GuanyuXu04/Maglev/scripts/coil_fit.png

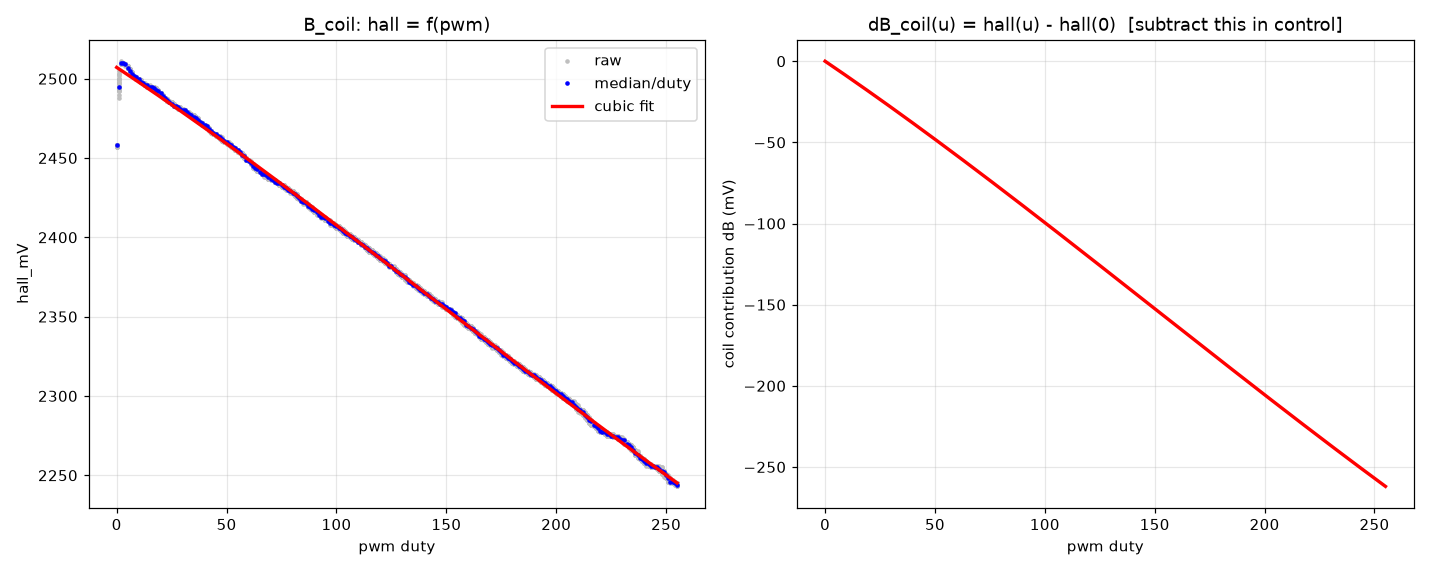
scripts/coil_fit.png
