GuanyuXu04/Maglev/scripts/PM2_fit.png

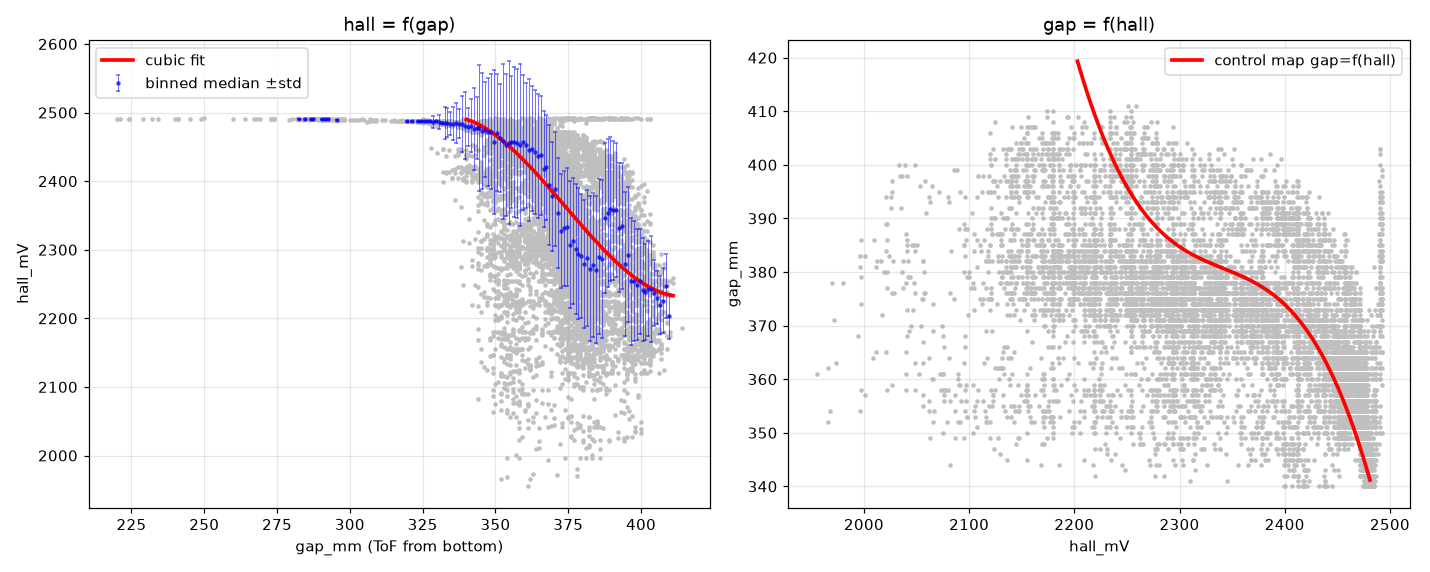
scripts/PM2_fit.png
