GuanyuXu04/Maglev/scripts/PM3_fit.png

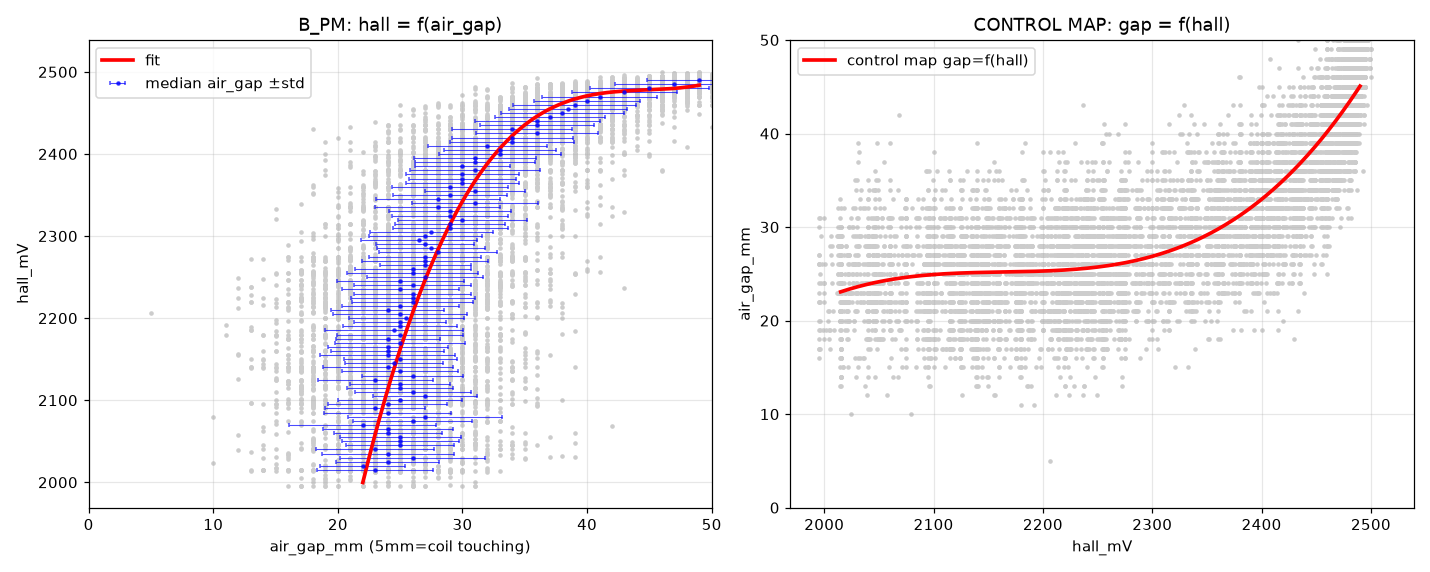
scripts/PM3_fit.png
