GuanyuXu04/Maglev/scripts/PM_plot.png

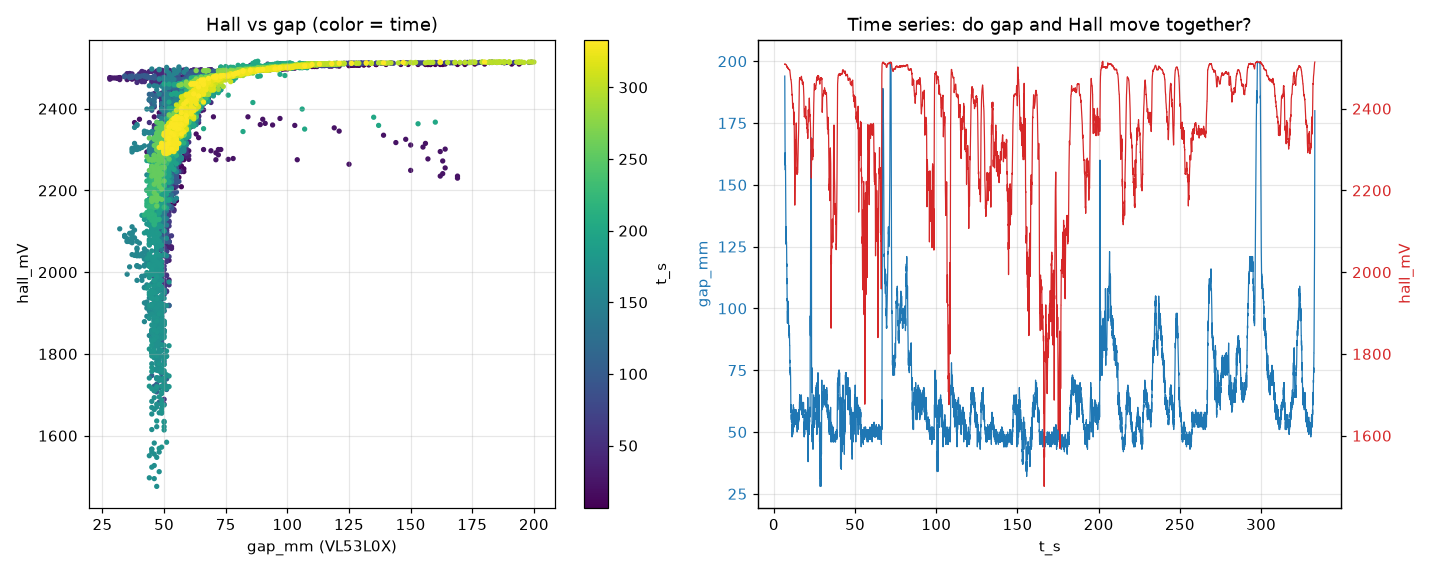
scripts/PM_plot.png
