GuanyuXu04/Maglev/scripts/process_data/figures/steady_state_error.png

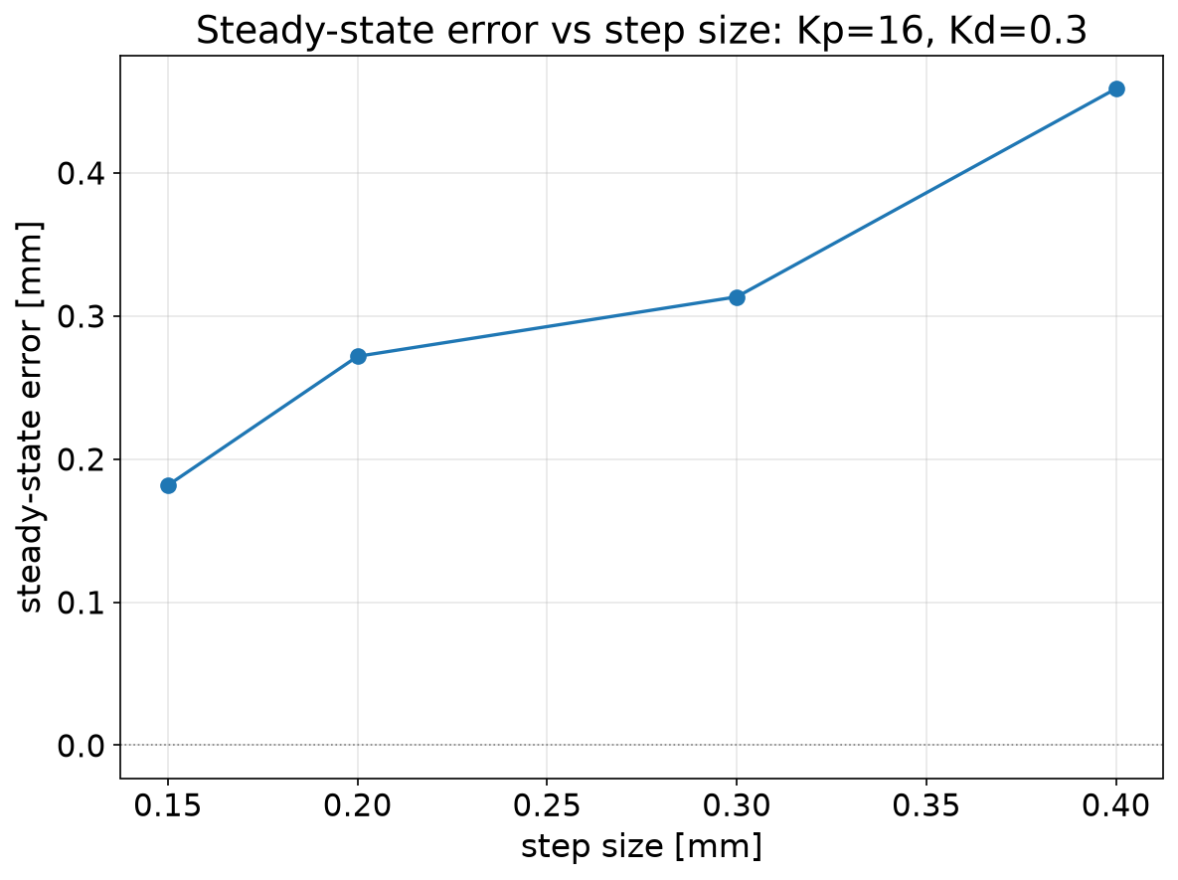
scripts/process_data/figures/steady_state_error.png
