GuanyuXu04/Maglev/scripts/sweep_kp_kd/steady_state_error_heatmap.png

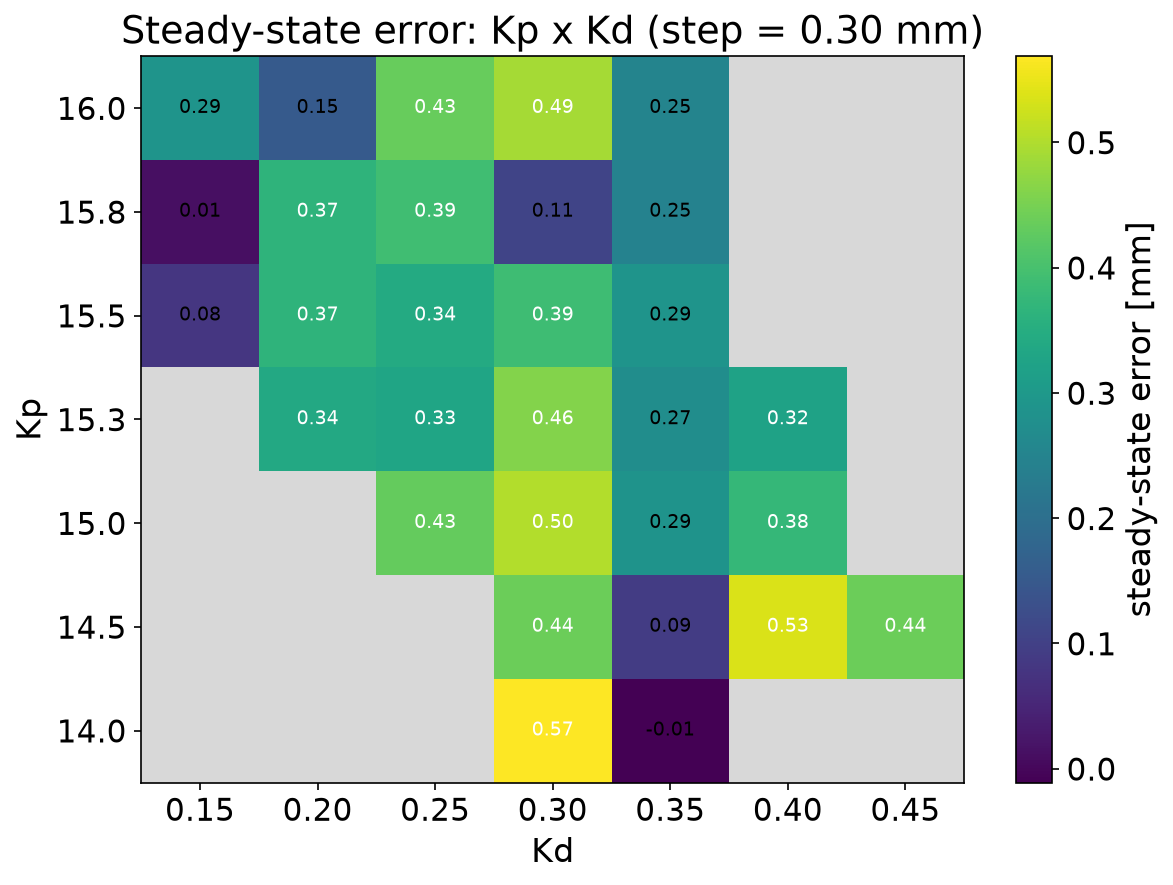
scripts/sweep_kp_kd/steady_state_error_heatmap.png
