GuanyuXu04/Maglev/scripts/process_data/figures/data_step_0.30.png

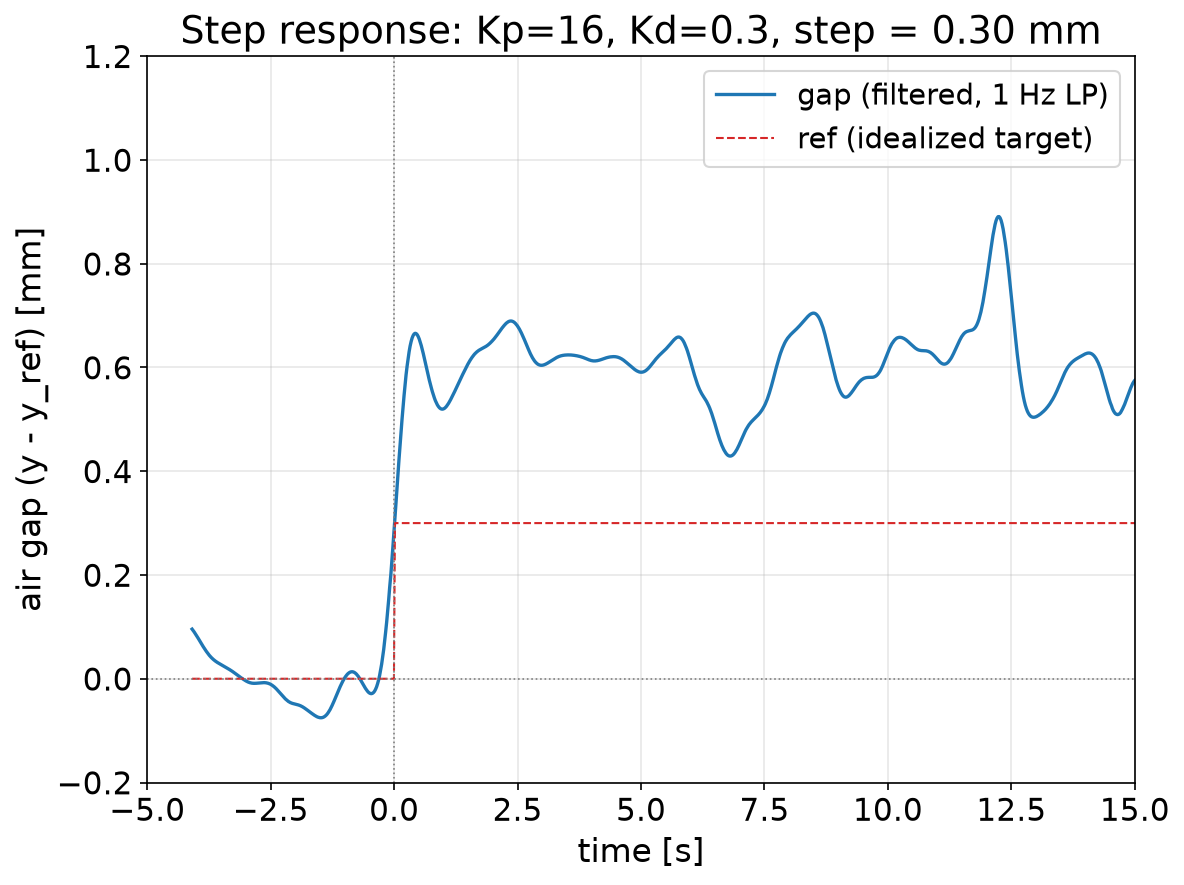
scripts/process_data/figures/data_step_0.30.png
