GuanyuXu04/Maglev/scripts/process_data/figures/data_step_0.60.png

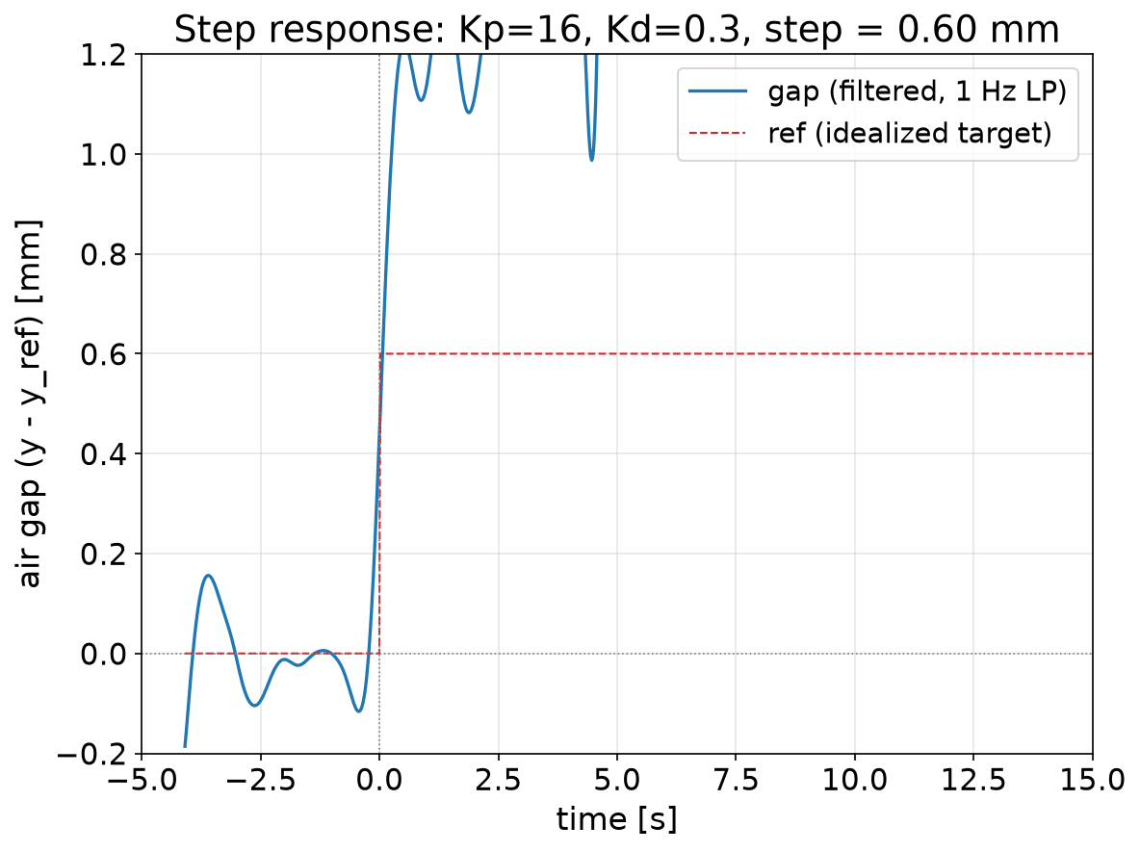
scripts/process_data/figures/data_step_0.60.png
