GuanyuXu04/Maglev/scripts/process_data/figures/step_comparison.png

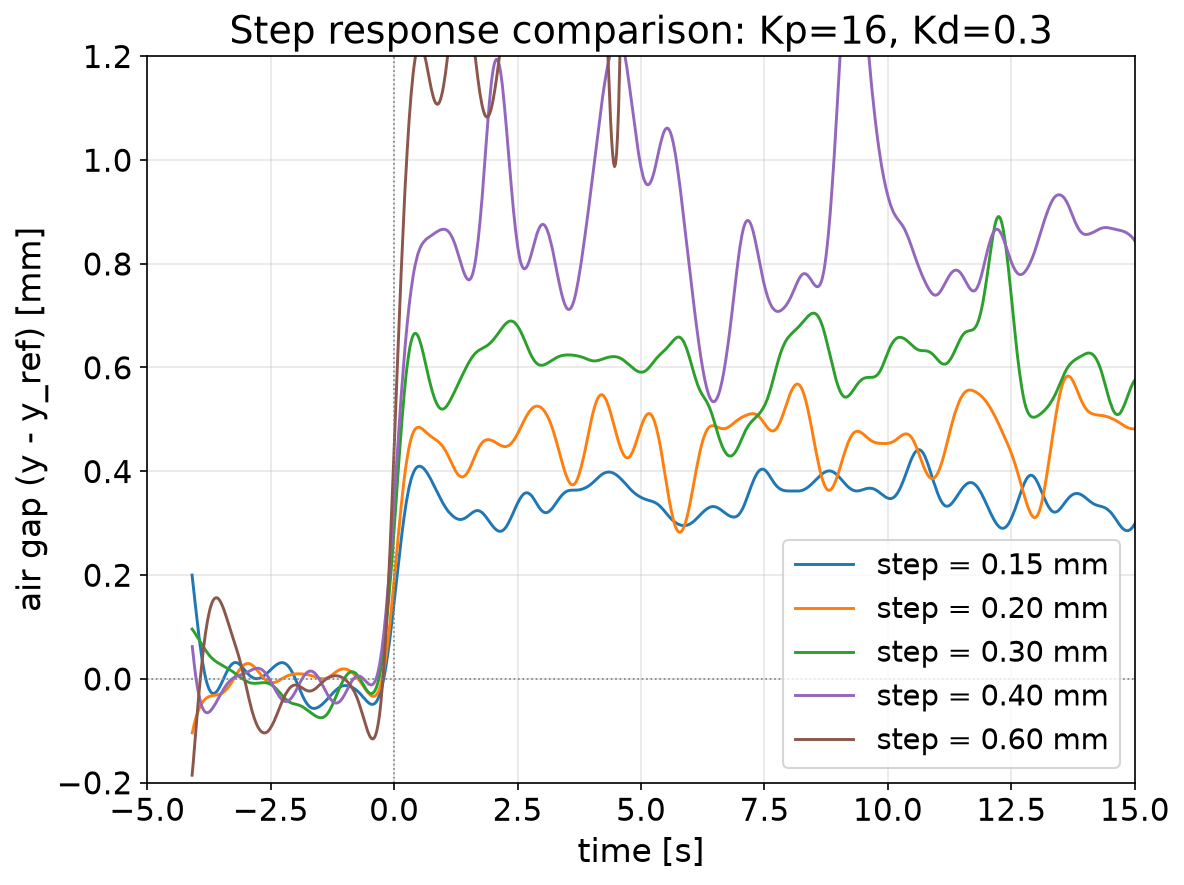
scripts/process_data/figures/step_comparison.png
