GuanyuXu04/Maglev/scripts/sweep_kp_kd/step_kp14.0_kd0.35.png

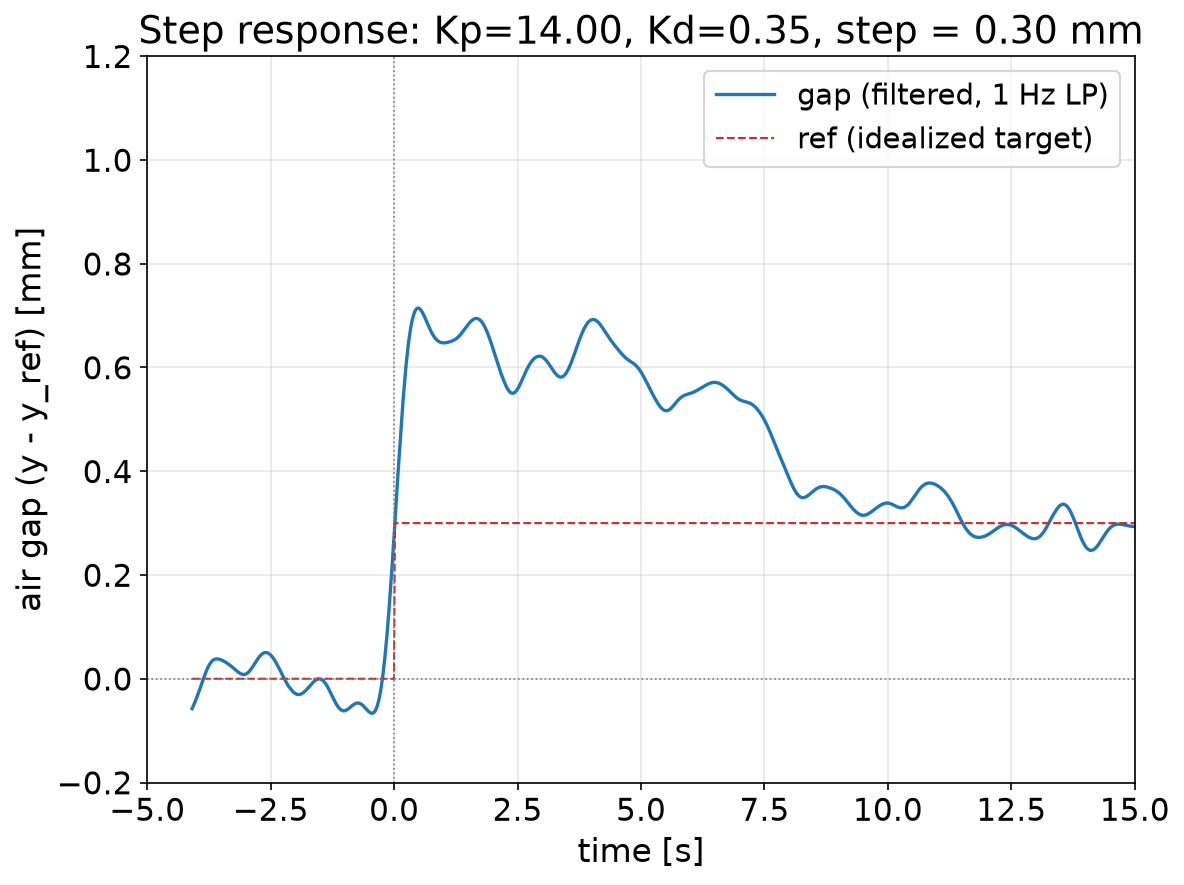
scripts/sweep_kp_kd/step_kp14.0_kd0.35.png
