GuanyuXu04/Maglev/scripts/sweep_kp_kd/step_kp14.5_kd0.30.png

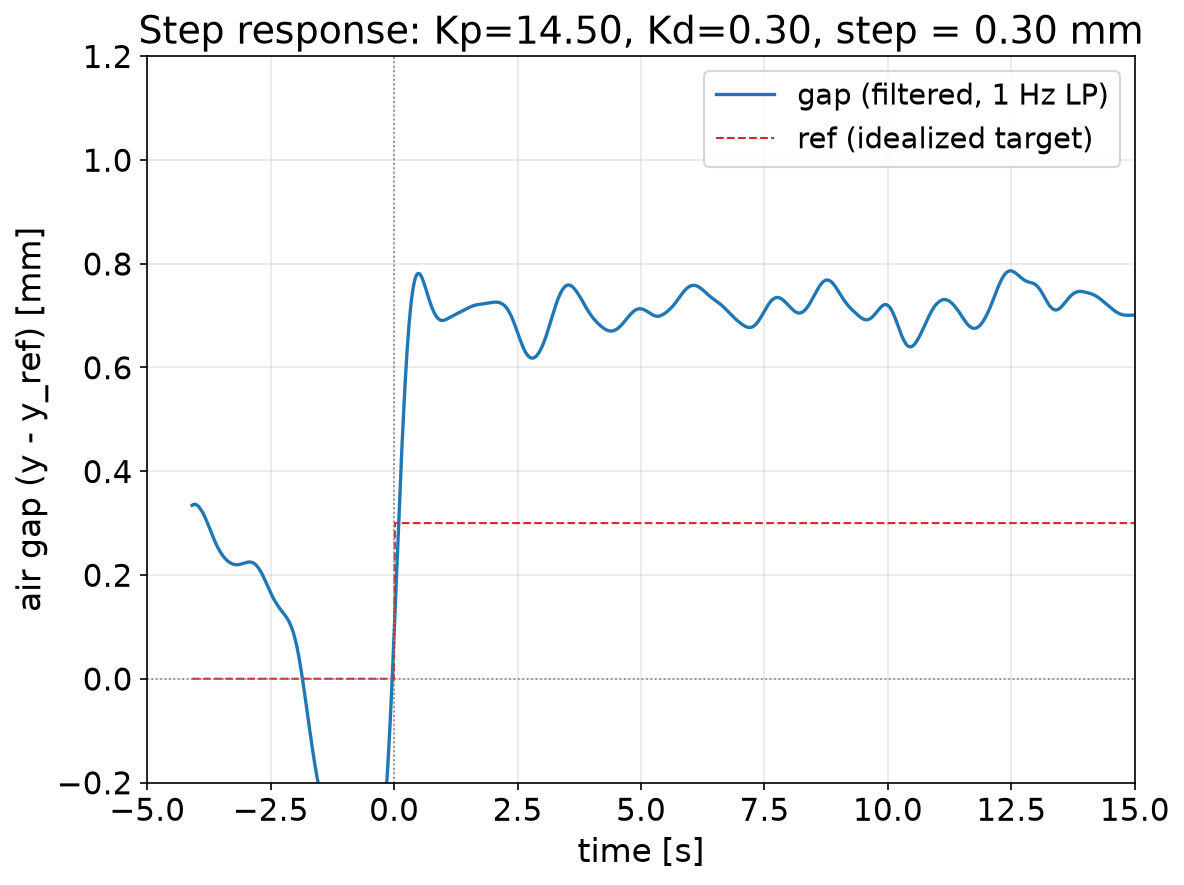
scripts/sweep_kp_kd/step_kp14.5_kd0.30.png
