GuanyuXu04/Maglev/scripts/sweep_kp_kd/step_kp15.0_kd0.20.png

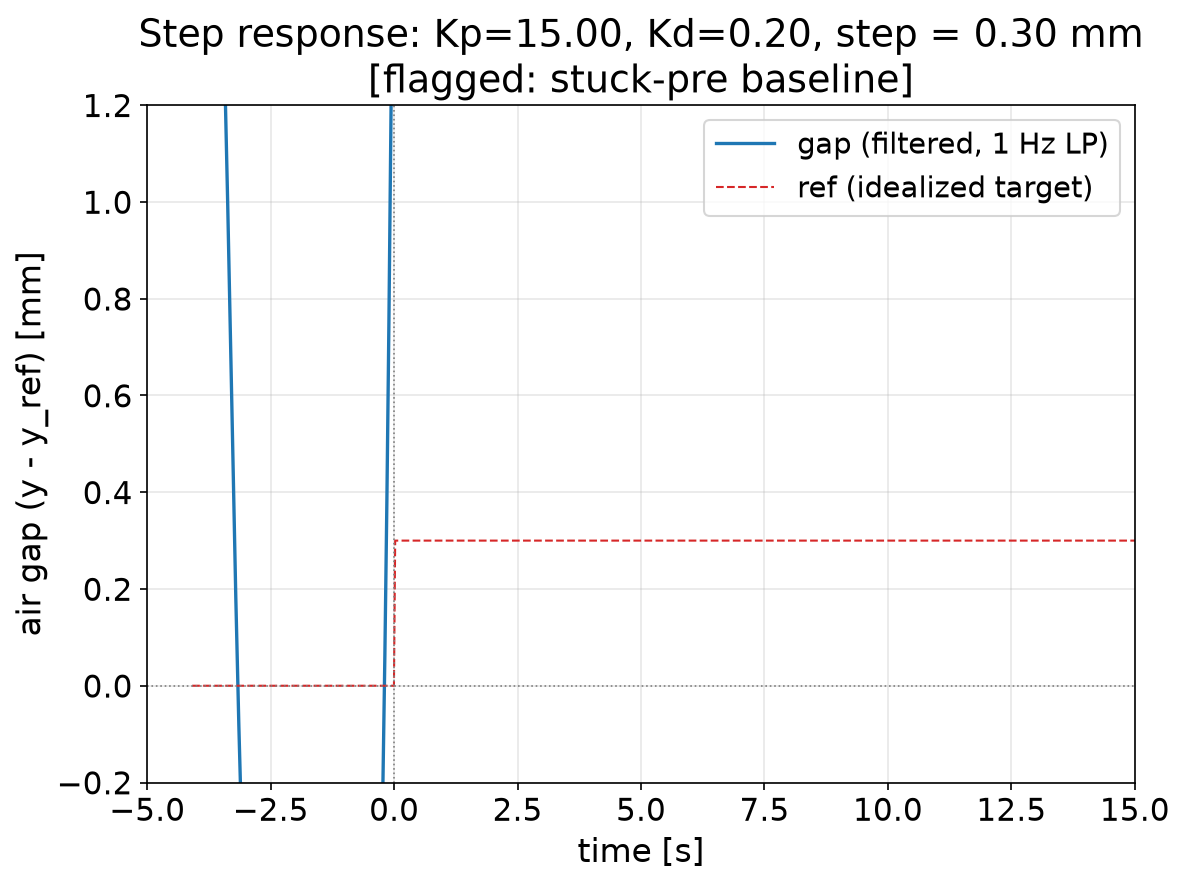
scripts/sweep_kp_kd/step_kp15.0_kd0.20.png
