GuanyuXu04/Maglev/scripts/sweep_kp_kd/step_kp15.0_kd0.25.png

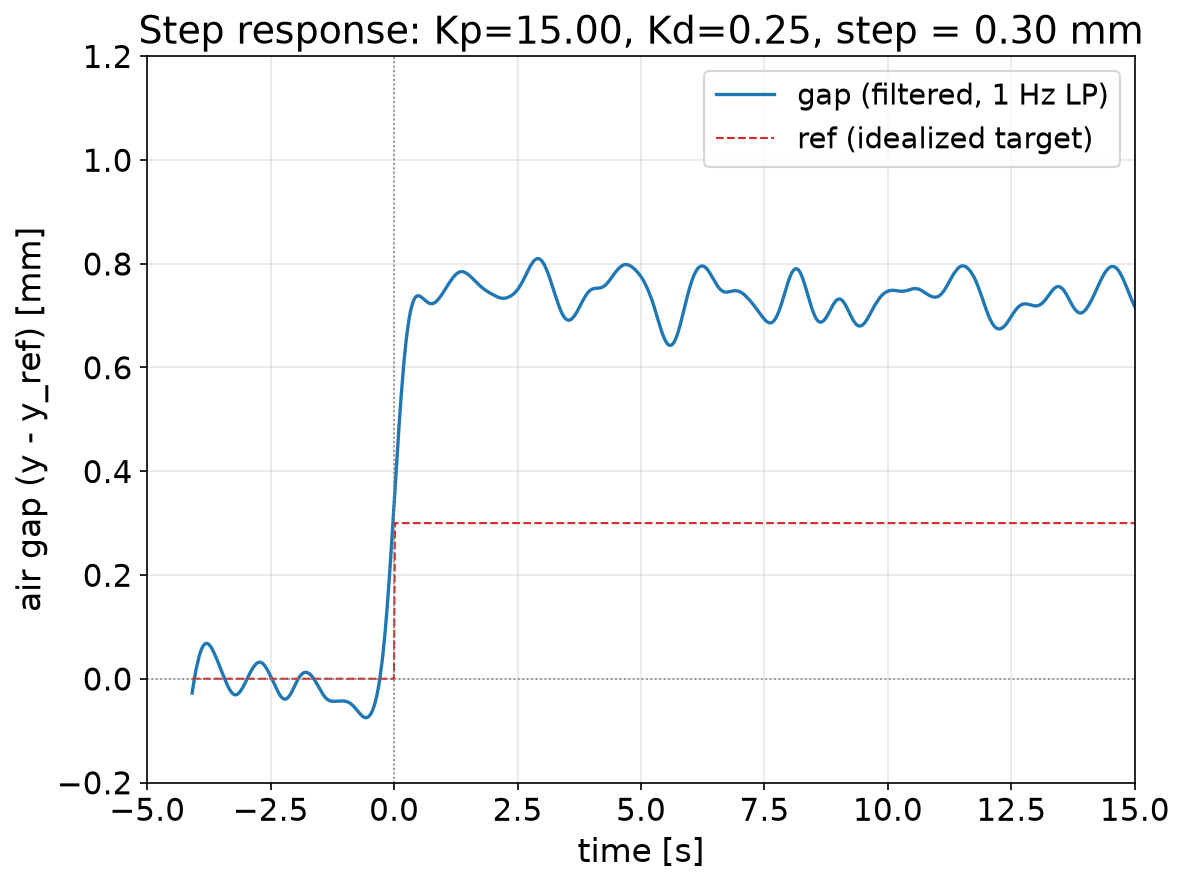
scripts/sweep_kp_kd/step_kp15.0_kd0.25.png
