GuanyuXu04/Maglev/scripts/sweep_kp_kd/step_kp15.0_kd0.30.png

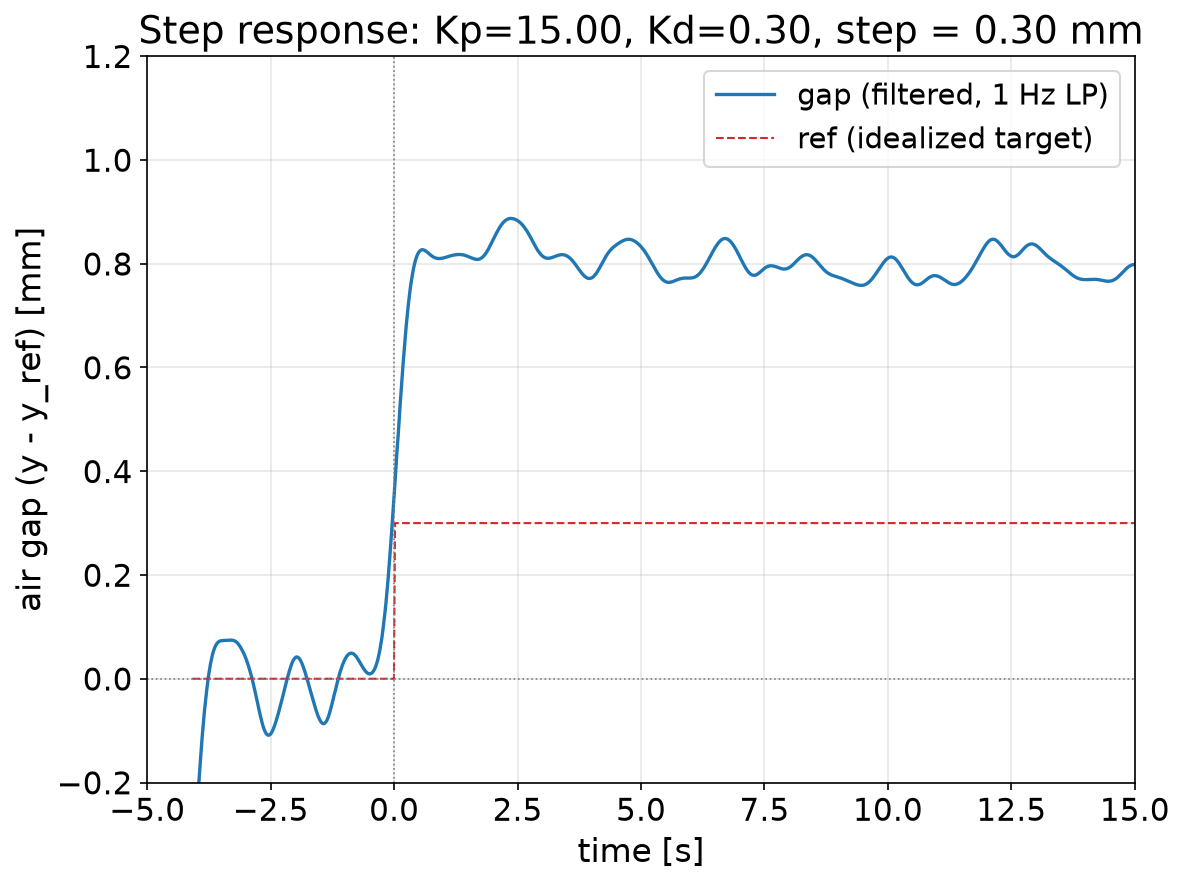
scripts/sweep_kp_kd/step_kp15.0_kd0.30.png
