GuanyuXu04/Maglev/scripts/sweep_kp_kd/step_kp15.3_kd0.25.png

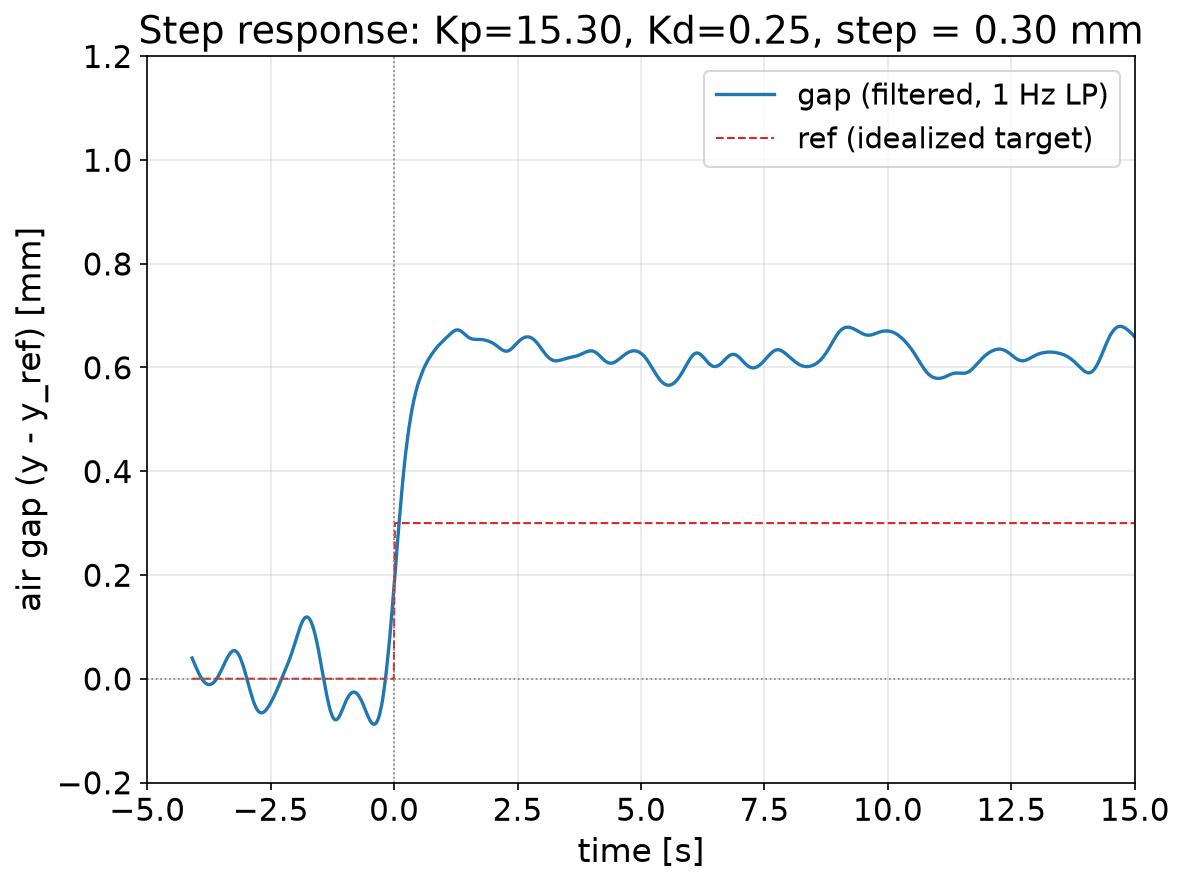
scripts/sweep_kp_kd/step_kp15.3_kd0.25.png
