GuanyuXu04/Maglev/scripts/sweep_kp_kd/step_kp15.5_kd0.35.png

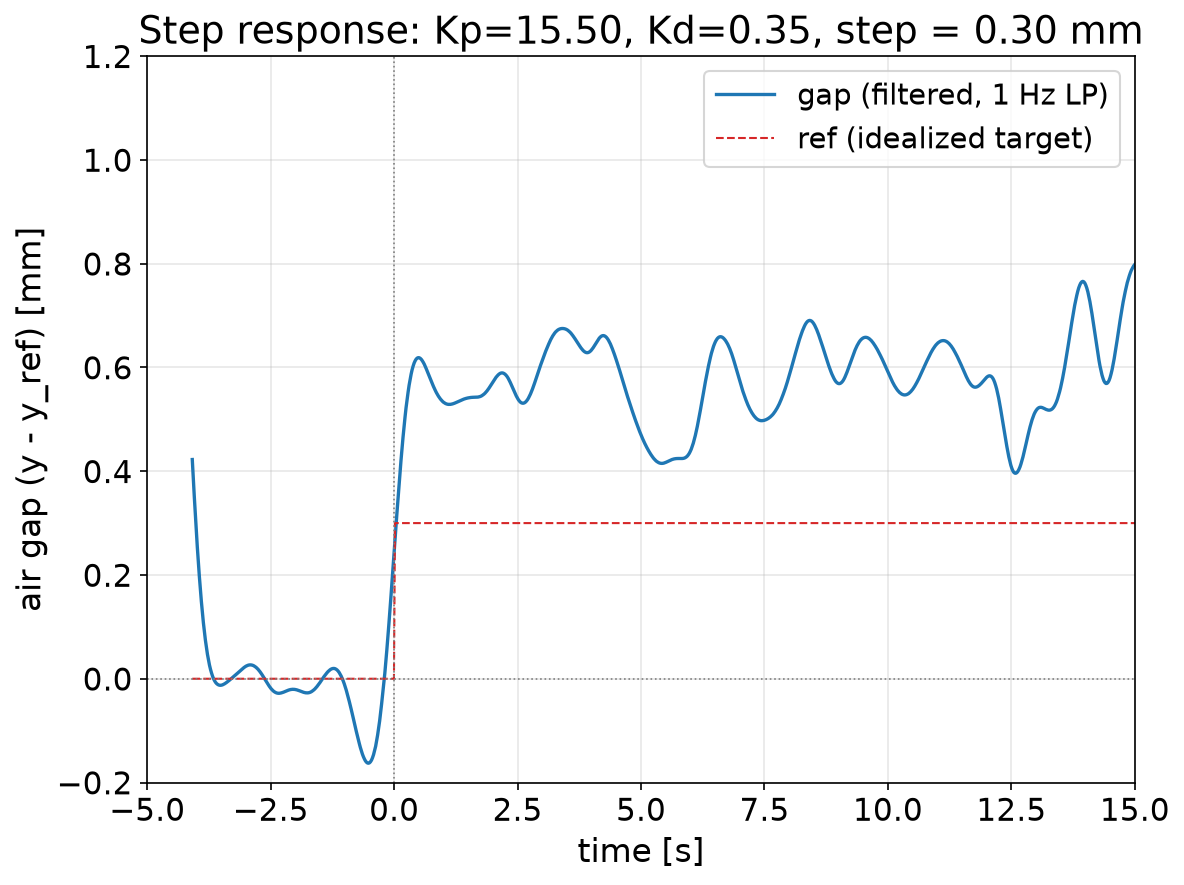
scripts/sweep_kp_kd/step_kp15.5_kd0.35.png
