GuanyuXu04/Maglev/scripts/sweep_kp_kd/step_kp15.5_kd0.40.png

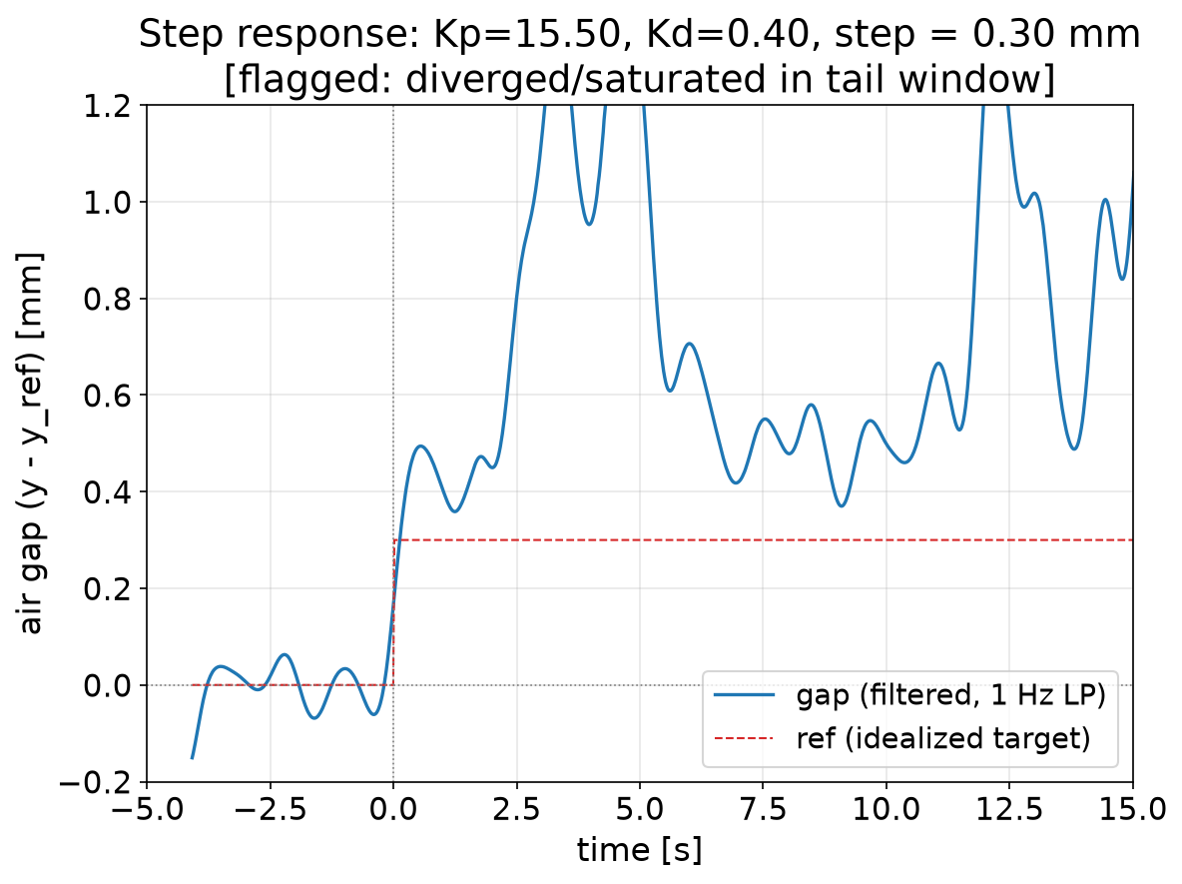
scripts/sweep_kp_kd/step_kp15.5_kd0.40.png
