GuanyuXu04/Maglev/scripts/sweep_kp_kd/step_kp15.8_kd0.15.png

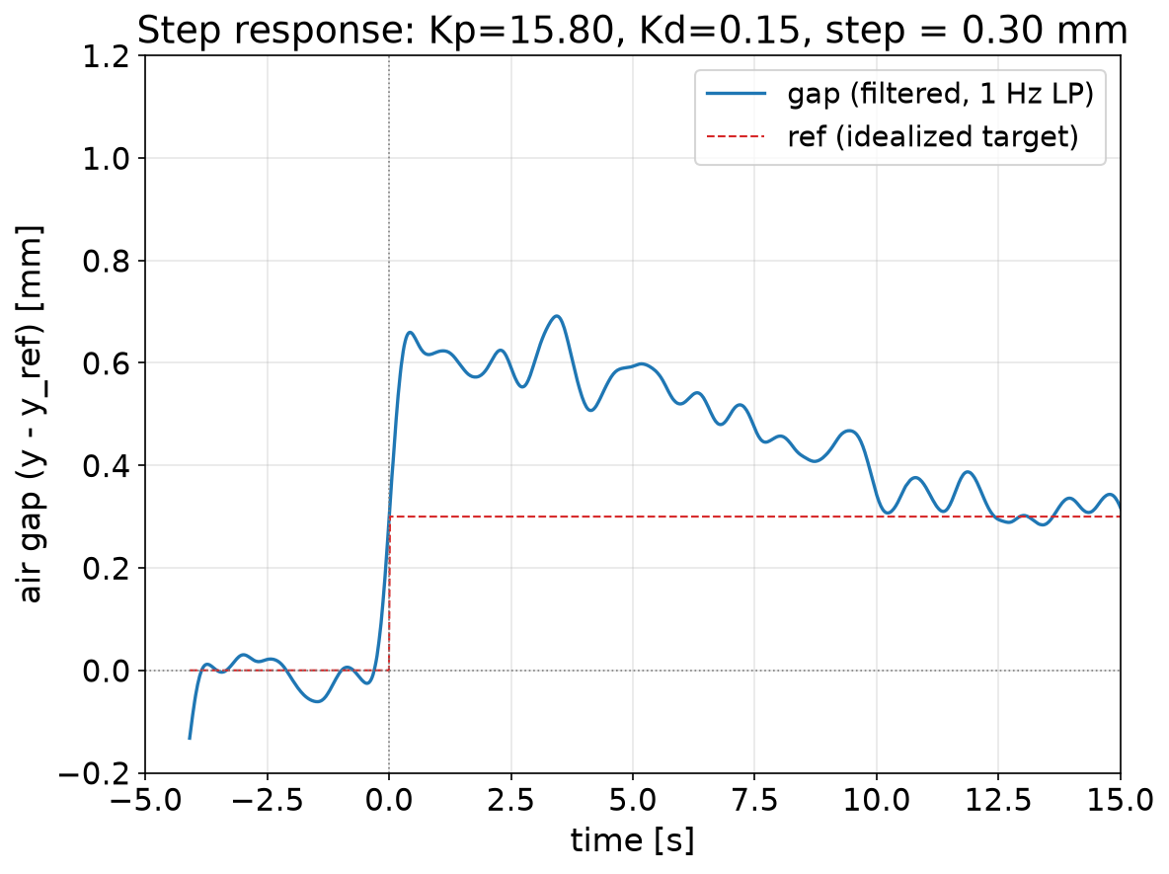
scripts/sweep_kp_kd/step_kp15.8_kd0.15.png
