GuanyuXu04/Maglev/scripts/sweep_kp_kd/step_kp15.8_kd0.35.png

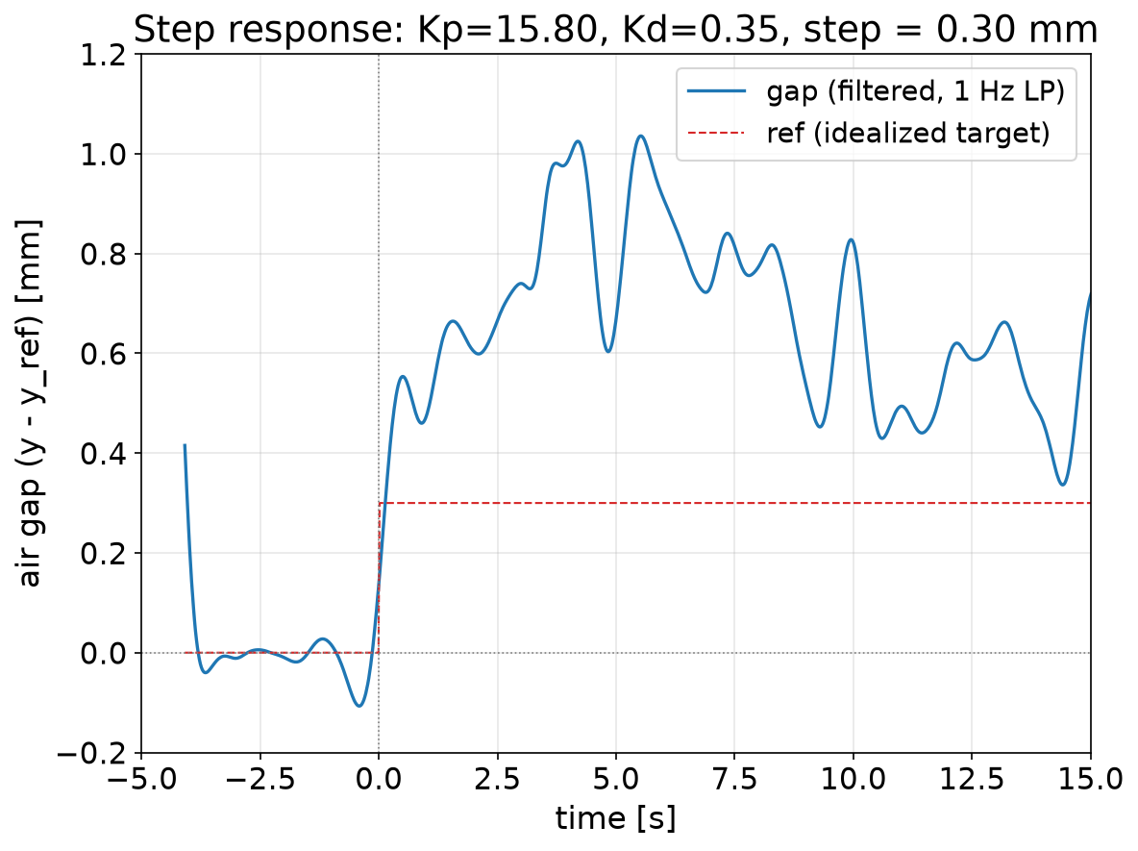
scripts/sweep_kp_kd/step_kp15.8_kd0.35.png
