GuanyuXu04/Maglev/scripts/sweep_kp_kd/step_kp16.0_kd0.15.png

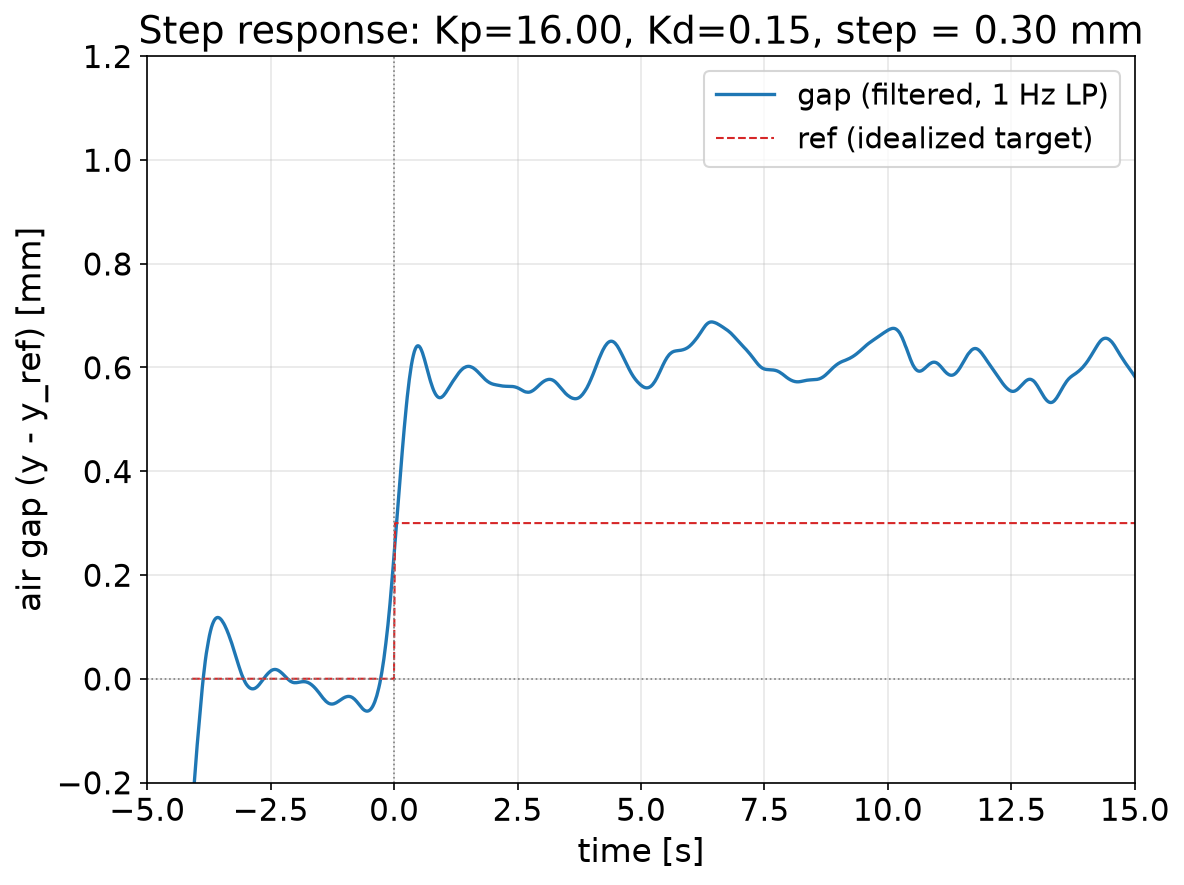
scripts/sweep_kp_kd/step_kp16.0_kd0.15.png
