GuanyuXu04/Maglev/scripts/sweep_kp_kd/step_kp16.0_kd0.35.png

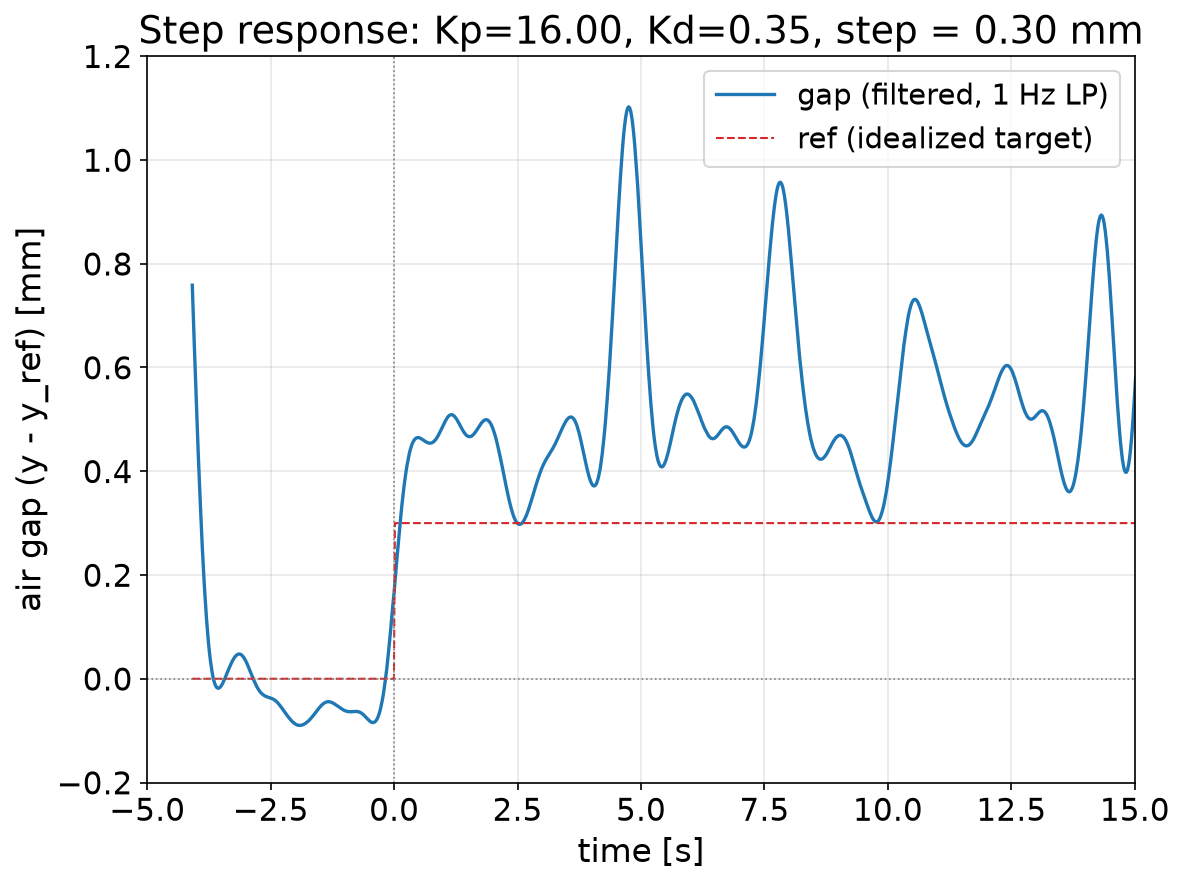
scripts/sweep_kp_kd/step_kp16.0_kd0.35.png
