GuanyuXu04/Maglev/scripts/sweep_step_kp16_kd0.3/data_step_0.40_normalized.png

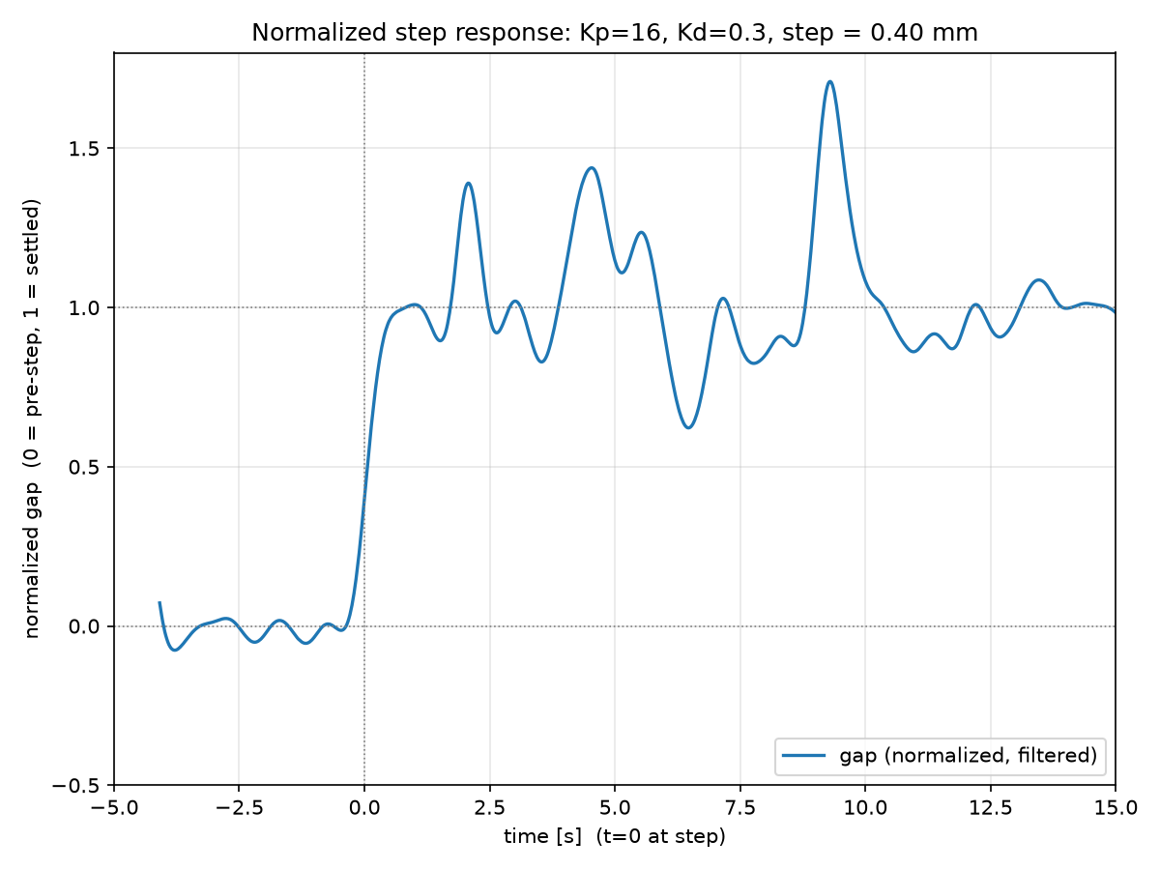
scripts/sweep_step_kp16_kd0.3/data_step_0.40_normalized.png
