GuanyuXu04/Maglev/python/maglev_sim/params.py

"""Single source of truth for every physical/design parameter.

See ../../PARAMETERS.md for the full discussion of where each number comes
from (direct measurement, design choice, or derived via calibration). Every
number here is a *placeholder* self-consistent with the equilibrium
equation `m*g = K*i0/y0**2 + K_pm/y0**4` (the second term is the
permanent-magnet-on-core attraction added to the plant model -- see
PARAMETERS.md "Permanent-magnet core-magnetization force") -- not a claim
about any real hardware.

The Arduino sketch (arduino/maglev_controller/maglev_controller.ino) hardcodes
the same numeric values in its constants block. `tests/test_maglev_sim.py`
parses that file and checks it against this module so the two cannot
silently drift apart -- if you change a value here, update the .ino too.
"""

from dataclasses import dataclass


@dataclass(frozen=True)
class PlantParams:
    """Physical constants. Bucket A (measure) + Bucket C (derive from calibration)."""

    g: float = 9.81          # m/s^2 -- standard gravity, not measured
    m: float = 0.020         # kg -- PLACEHOLDER, replace with a scale reading
    R: float = 8.0           # ohm -- PLACEHOLDER, replace with a multimeter reading
    L: float = 0.020         # H   -- PLACEHOLDER, replace with an LR step-response test
    K: float = 1.1649375e-3  # N*m^2/A -- coil constant, derived via K_from_equilibrium()
                             # so the coil AND K_pm together satisfy equilibrium (below)
    K_pm: float = 6.13125e-8 # N*m^4 -- permanent-magnet-magnetizes-the-core attraction,
                             # F_pm = K_pm/y^4, always upward. PLACEHOLDER: chosen so this
                             # term supplies 5% of the hover force at (y0, i0). See
                             # PARAMETERS.md "Permanent-magnet core-magnetization force".


@dataclass(frozen=True)
class OperatingPoint:
    """Bucket B design choices: where we linearize around.

    y0=50mm (not a smaller, tighter gap) is a deliberate choice, not
    arbitrary: see PARAMETERS.md "Why a 30Hz sensor cannot stabilize this
    plant". At y0=10mm, no achievable ~30-60Hz sensor rate can stabilize
    this plant at all (the mechanical open-loop instability's own time
    constant is faster than one sample period), regardless of gains or
    control architecture. `b = 2g/y0` shrinks as y0 grows, slowing that
    instability; 50mm is the smallest gap (checked by direct discrete
    forward-simulation, not asserted) at which a 60Hz sensor is stable with
    real margin -- down to ~45Hz, not just exactly at 60Hz -- with the
    existing single-loop design. (40mm technically works at exactly 60Hz
    too, but with zero margin: 50Hz already fails catastrophically there,
    too fragile against real sensor-rate variation to commit to.)
    """

    y0: float = 0.050        # m -- equilibrium gap
    i0: float = 0.400        # A -- equilibrium coil current


@dataclass(frozen=True)
class LoopTiming:
    """Bucket B design choices: sample time and derivative filter."""

    dt: float = 0.001        # s -- control loop tick (1 kHz); see PARAMETERS.md
                             # "electrical-pole aliasing" -- 200 Hz was too slow
                             # to resolve the coil's ~2.5ms electrical time
                             # constant and was discrete-time unstable.
    tau: float = 0.010       # s -- derivative low-pass filter time constant


@dataclass(frozen=True)
class ActuatorLimits:
    """Hardware limits for the LMD18200 H-bridge + supply."""

    supply_voltage: float = 12.0   # V -- assumed bench supply
    pwm_max: int = 255             # 8-bit analogWrite range
    current_limit: float = 3.0     # A -- LMD18200 continuous rating (datasheet)


@dataclass(frozen=True)
class TravelLimits:
    """The rig's physical rail: a ground below and the electromagnet's face
    above, bounding how far the magnet can actually move. Bucket A/B: `y_max`
    is a measurement (the rail length you build/measure on your rig -- 450mm
    here); `y_min` is a small design/numerical floor, not a measurement --
    see PARAMETERS.md "Ground and ceiling travel limits" for why it can't be
    exactly 0.
    """

    y_max: float = 0.450    # m -- magnet resting on the ground ("ground")
    y_min: float = 0.0005   # m -- magnet against the electromagnet's face ("ceiling")


PLANT = PlantParams()
OP = OperatingPoint()
LOOP = LoopTiming()
ACTUATOR = ActuatorLimits()
LIMITS = TravelLimits()


def K_from_equilibrium(m: float, g: float, y0: float, i0: float, K_pm: float = 0.0) -> float:
    """K derived from a single hovering calibration point (PARAMETERS.md, bucket C).

    With the permanent-magnet core-magnetization term F_pm = K_pm/y0**4 (always
    upward) also present, the hover force balance is
    `m*g = K*i0/y0**2 + K_pm/y0**4`, so the coil's share is `m*g - K_pm/y0**4`.
    K_pm defaults to 0.0 (the original README coil-only model).
    """
    return (m * g - K_pm / y0 ** 4) * y0 ** 2 / i0


def u0_from_equilibrium(i0: float, R: float) -> float:
    """Equilibrium coil voltage: at DC, L*di/dt = 0, so u0 = i0*R."""
    return i0 * R


def check_equilibrium_consistency(plant: PlantParams = PLANT, op: OperatingPoint = OP,
                                   rtol: float = 1e-9) -> None:
    """Raise if the committed placeholder numbers don't satisfy the hover force
    balance `m*g = K*i0/y0**2 + K_pm/y0**4` (coil pull + permanent-magnet
    core-magnetization pull, both upward).

    This is a guard against editing one placeholder number without the others --
    the whole point of the "self-consistent fictional data sheet" is that it
    stays consistent.
    """
    lhs = plant.m * plant.g
    rhs = plant.K * op.i0 / op.y0 ** 2 + plant.K_pm / op.y0 ** 4
    if abs(lhs - rhs) > rtol * max(abs(lhs), abs(rhs), 1e-12):
        raise ValueError(
            f"Equilibrium violated: m*g={lhs:.6e} but "
            f"K*i0/y0**2 + K_pm/y0**4={rhs:.6e}. Either recompute K via "
            "K_from_equilibrium(m, g, y0, i0, K_pm), or fix whichever "
            "placeholder changed."
        )
