GuanyuXu04/Maglev/(commit log)

2026-07-05 implement simulation and arduino code
2026-07-05 update arduino/README
2026-07-07 add Arduino sensor stub
2026-07-07 modify arduino code
2026-07-22 update arduino scripts
2026-07-25 before xinqi edition
    [run_20260725_135312_PM.csv, run_20260725_140747_PM.csv, run_20260725_140920_PM.csv, run_20260725_141717_PM.csv, run_20260725_142217_PM.csv, run_20260725_142530_PM.csv, run_20260725_142611_PM.csv, run_20260725_145045_PM.csv]
2026-07-25 data added
    [data_step_0.15.csv, data_step_0.20.csv, data_step_0.25.csv, data_step_0.30.csv, data_step_0.35.csv, data_step_0.40.csv, data_step_0.60.csv, data_step_0.80.csv]
2026-07-25 release data
    [data_step_0.15.csv, data_step_0.20.csv, data_step_0.25.csv, data_step_0.30.csv, data_step_0.35.csv, data_step_0.40.csv, data_step_0.60.csv, data_step_0.80.csv]
